DhanushMusunuru/FreshIQ/python/sample_data/tomato_spoiled.jpg

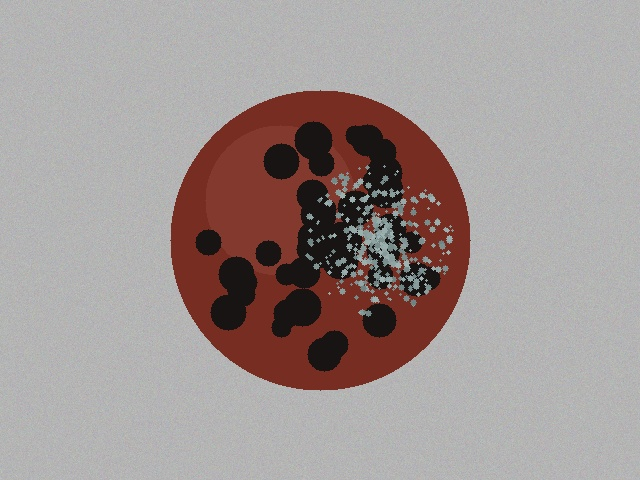
python/sample_data/tomato_spoiled.jpg
