DhanushMusunuru/FreshIQ/docs/schematics/freshiq-schematic.html

Sheet 1 of 1 · Rev A

# FreshIQ wiring

Tray drive and power for the FreshIQ inspection station. One 12 V supply, an A4988 driving a NEMA 17 from the UNO Q's 3.3 V header, a white LED strip and a USB camera.

Print / save as PDF

## Connections

A4988 | Goes to | Note
STEP | D2 | One pulse, one step.
DIR | D3 | Flip DIRECTION in the sketch if the tray turns the wrong way.
ENABLE | D5 | Active LOW. Held HIGH between moves so the motor is not left energised.
VDD | +3V3 | Logic supply. Not +5 V — see below.
GND (logic) | GND rail | Shared reference.
VMOT | +12 V | With C1 across it.
GND (motor) | GND rail | Star back to J1.
1A 1B | black, green | One coil — verify by continuity.
2A 2B | red, blue | The other coil.
MS1 MS2 MS3 | open | Full step. Internal pull-downs make open the default.
RESET + SLEEP | each other | JP1. A wire you add.

## Before first power-up

VDD must be 3.3 V

The A4988 reads logic HIGH at roughly 0.7 × VDD. On 5 V that threshold is 3.5 V and the UNO Q's outputs only reach 3.3 V, so STEP is never reliably seen. The motor then twitches, or works until it warms up — a fault that reads like a dead driver.

JP1 is not a factory jumper

RESET and SLEEP both float, and a floating RESET holds the chip in reset forever. Nothing moves and nothing is damaged, which is why people replace working drivers over it.

Fit C1 first

100 µF across VMOT and GND, within 50 mm of the driver. Motor inductance plus supply leads makes an LC circuit; powering up without bulk capacitance produces a spike well past 12 V that destroys the A4988. Same failure if you unplug the motor while powered.

## Current limit

Set it with a multimeter between the trimpot wiper and ground before the first move: Vref = I × 8 × Rsense. For 1.0 A with R100 (0.1 Ω) sense resistors that is 0.80 V; with R050 it is 0.40 V. The 17HS4401 is rated 1.68 A, but this tray is light and slow — 1.0 A runs cooler and costs nothing here.

FreshIQ · 4 compartments · 12 V 3 A · STEP D2, DIR D3, ENABLE D5. The drawing is also stored on its own as freshiq-wiring.svg.
