DhanushMusunuru/FreshIQ/python/sample_data/bad_blurred.jpg

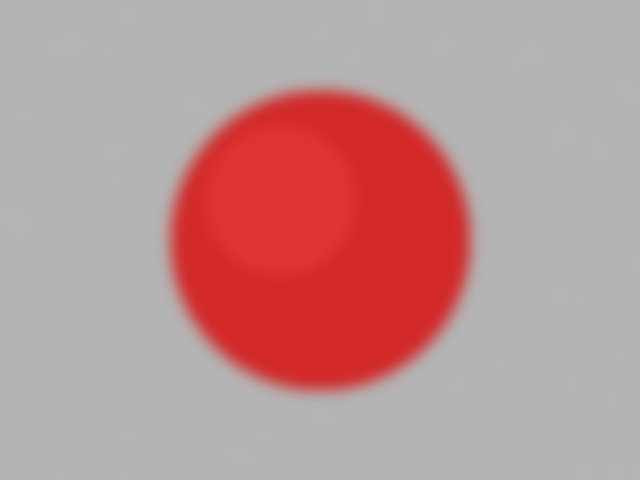
python/sample_data/bad_blurred.jpg
