DhanushMusunuru/FreshIQ/python/sample_data/bad_too_dark.jpg

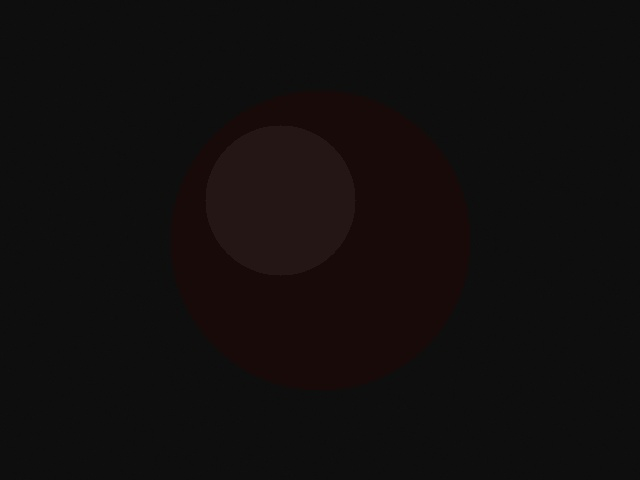
python/sample_data/bad_too_dark.jpg
