DhanushMusunuru/FreshIQ/python/sample_data/banana_fresh.jpg

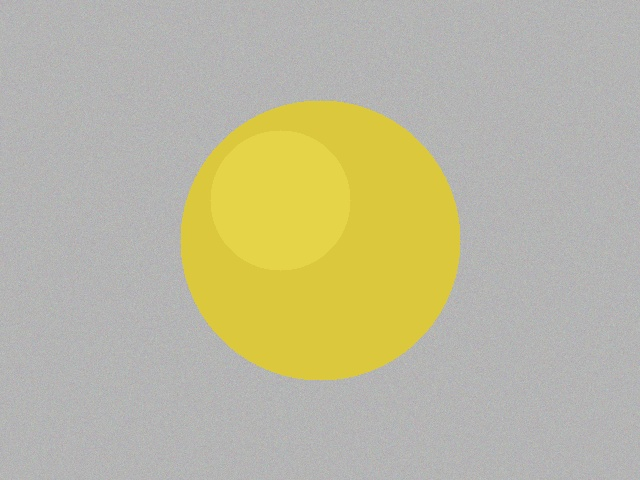
python/sample_data/banana_fresh.jpg
