DhanushMusunuru/FreshIQ/cad/export/step/FreshIQ_assembly.step

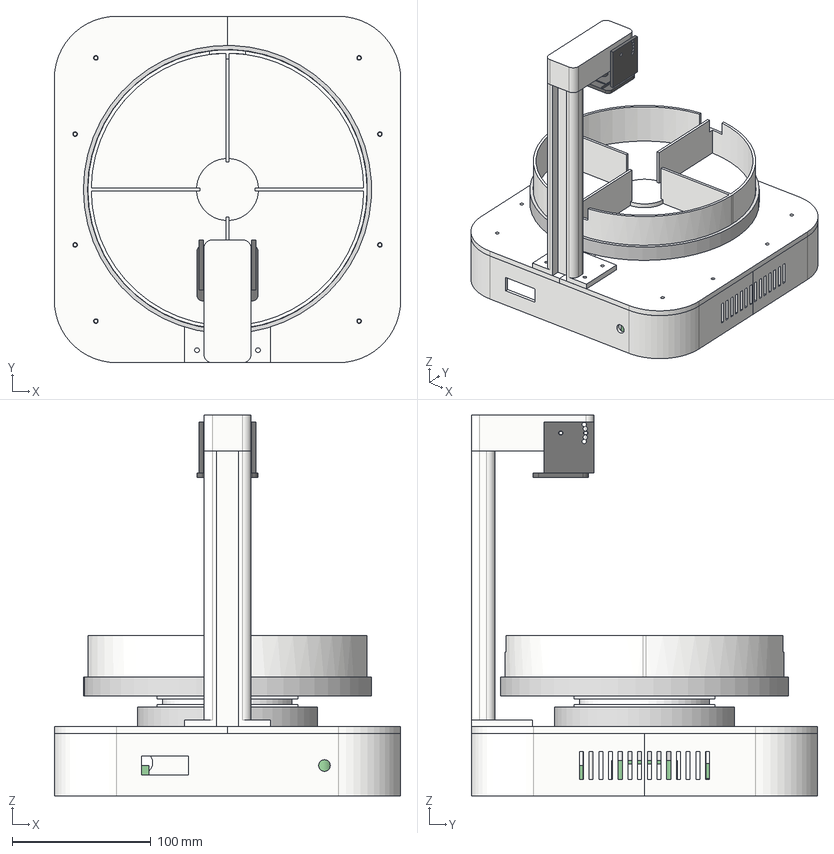
[picture p9: CAD file, 2026-08-23]
cad/export/step/FreshIQ_assembly.step
250.0 x 250.0 x 275.0 mm
