DhanushMusunuru/FreshIQ/cad/export/stl/05_Arm_Post.stl

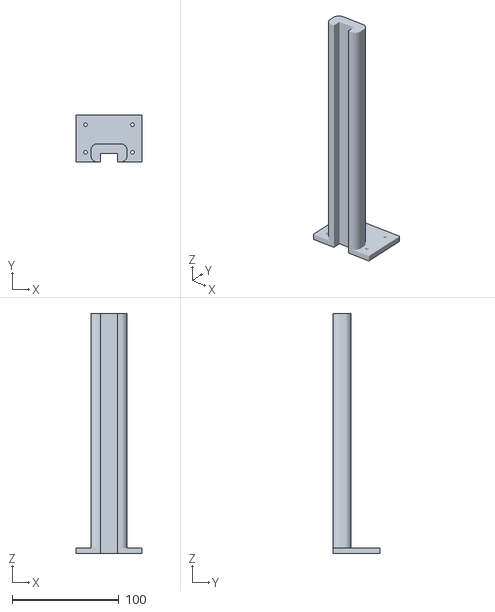
[picture p10: CAD file, 2026-08-23]
cad/export/stl/05_Arm_Post.stl
62.0 x 44.0 x 225.0
