DhanushMusunuru/FreshIQ/cad/export/stl/01_Base_Shell_A.stl

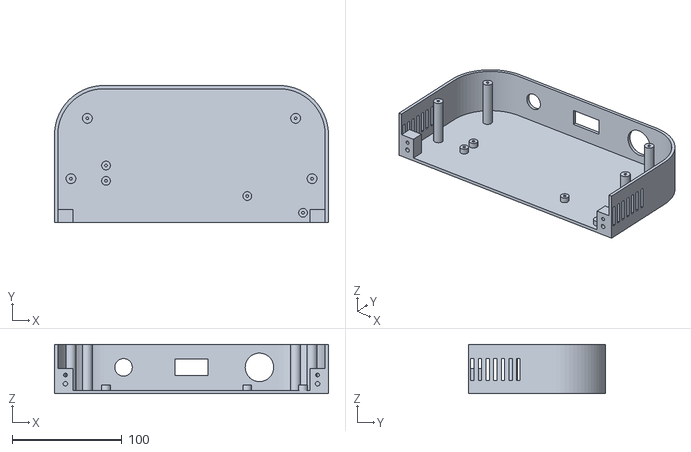
[picture p11: CAD file, 2026-08-23]
cad/export/stl/01_Base_Shell_A.stl
250.0 x 125.0 x 45.0
