DhanushMusunuru/FreshIQ/cad/export/stl/06_Arm_Head.stl

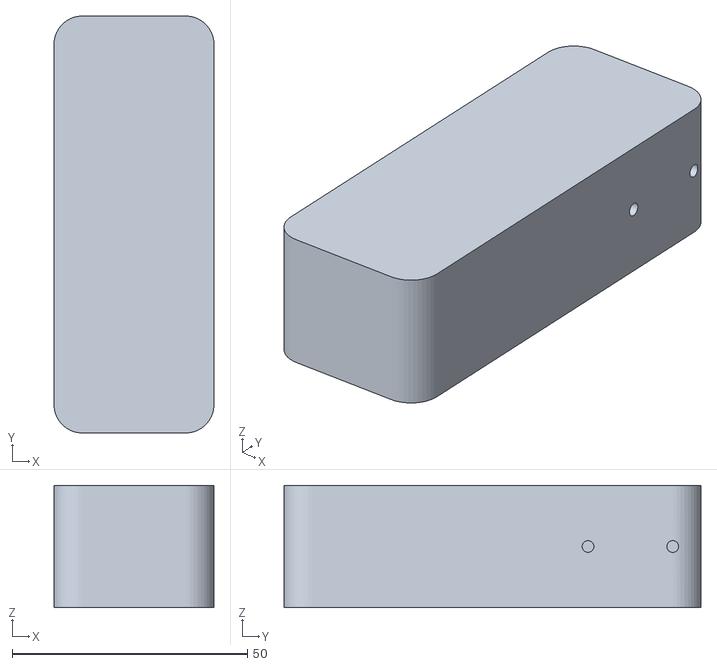
[picture p12: CAD file, 2026-08-23]
cad/export/stl/06_Arm_Head.stl
34.0 x 88.6 x 26.0
