DhanushMusunuru/FreshIQ/cad/export/stl/02_Deck_A.stl

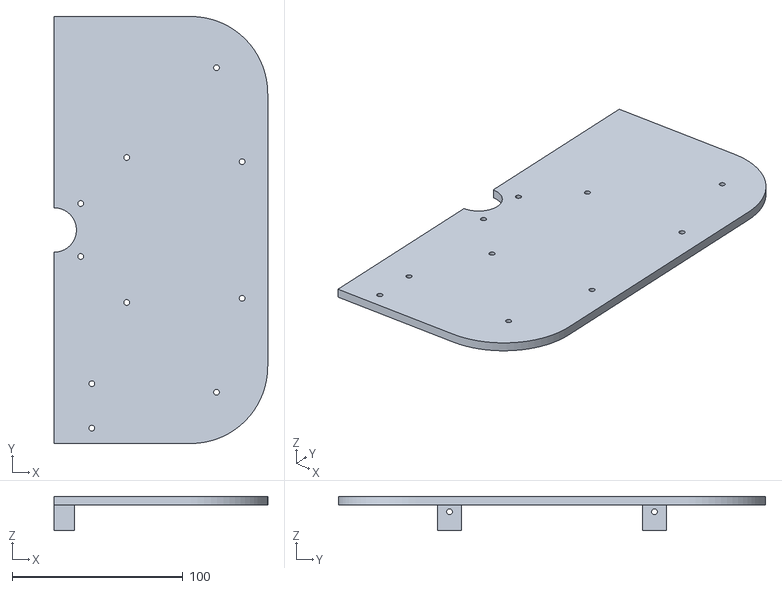
[picture p13: CAD file, 2026-08-23]
cad/export/stl/02_Deck_A.stl
125.0 x 250.0 x 20.0
