DhanushMusunuru/FreshIQ/cad/export/stl/08_Tray_Insert.stl

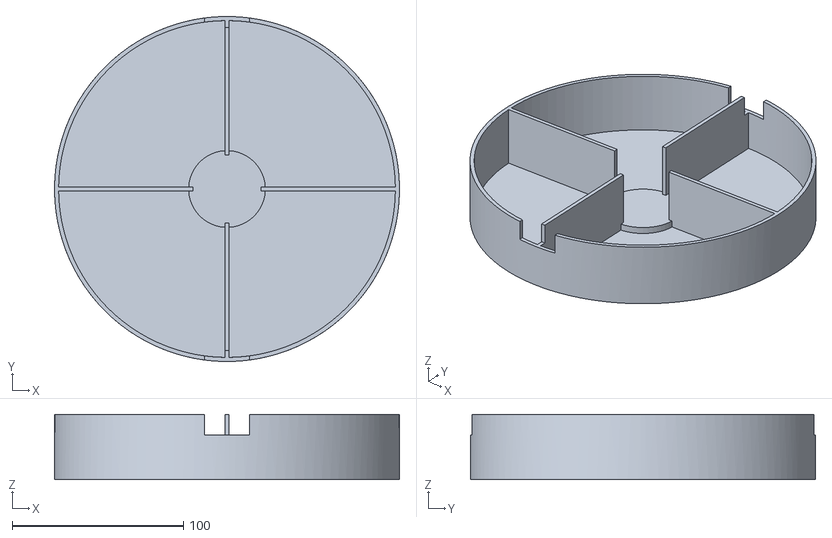
[picture p14: CAD file, 2026-08-23]
cad/export/stl/08_Tray_Insert.stl
201.5 x 201.5 x 38.0
