DhanushMusunuru/FreshIQ/cad/export/stl/03_Pedestal.stl

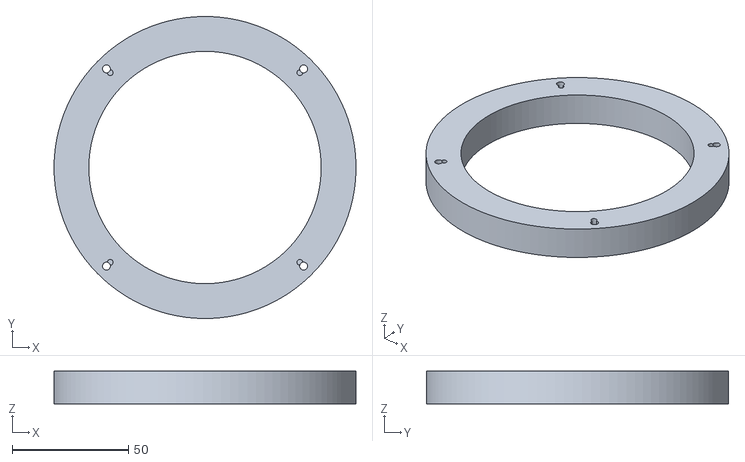
[picture p15: CAD file, 2026-08-23]
cad/export/stl/03_Pedestal.stl
130.0 x 130.0 x 14.1
