DhanushMusunuru/FreshIQ/cad/export/stl/07_Camera_Tilt_Bracket.stl

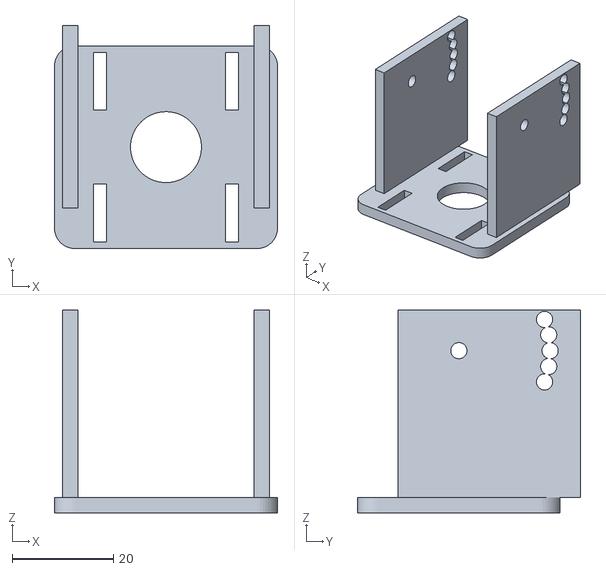
[picture p16: CAD file, 2026-08-23]
cad/export/stl/07_Camera_Tilt_Bracket.stl
44.0 x 44.0 x 40.0
