DhanushMusunuru/FreshIQ/cad/export/stl/04_Tray_Carrier.stl

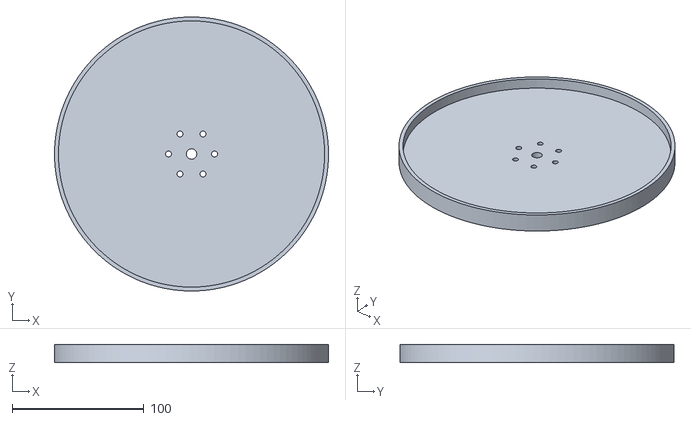
[picture p17: CAD file, 2026-08-23]
cad/export/stl/04_Tray_Carrier.stl
208.0 x 208.0 x 14.0
