DhanushMusunuru/FreshIQ/(list of files, cad)

Other CAD files:
cad/export/stl/02_Deck_B.stl
cad/export/stl/01_Base_Shell_B.stl
