DhanushMusunuru/FreshIQ/docs/freshiq-manual.html

Build & Wiring Manual

# FreshIQ

A four-compartment rotating tray that photographs each compartment in turn and classifies what it finds. One board does the vision and the web interface; a stepper indexes the tray. This is how it goes together and why it is built this way.

4 compartments 250 × 250 × 275 mm 12 V · 3 A 8 foods · 2 conditions 160 px model input 10 printed parts

## 01 How it works

Press Start scan. The tray turns one compartment, stops, waits for the platter to settle, takes a photo, classifies it, saves the result, and repeats until every compartment has an answer.

12 V power 3.3 V logic motor / data

One board, two processors. The UNO Q carries a Linux SoC and an STM32 microcontroller joined by an internal UART, so there is no external serial wiring — the driver connects straight to the 3.3 V header pins. That UART (/dev/ttyHS1) is owned exclusively by the arduino-router service, so Python reaches the MCU through the router's MessagePack-RPC socket, never by opening the port. Linux runs the model and the dashboard; the STM32 does the step timing, because Linux is not a real-time OS and a scheduler hiccup mid-step loses steps silently.

## 02 Parts list

Everything outside the printed enclosure.

Part | Spec | Notes
Arduino UNO Q | 4 GB | Linux + STM32 on one board. 68.6 × 53.3 mm. No barrel jack — power arrives on the VIN header pin.
NEMA 17 stepper | 17HS4401 class | 42.3 mm frame, 40 mm body, Ø5 mm shaft, 1.8°/step, 200 steps/rev.
A4988 carrier | 15.2 × 20.3 mm | Pololu-format. Check the sense resistors — see §5.
Coupling hub | Ø5 mm bore | Ø47 flange, 6 holes on 35 mm PCD, ~20 mm long. Measure yours — it sets the pedestal height.
Lazy-susan bearing | 4 in square | 101.6 mm plates, 7.94 mm thick, Ø57.15 mm access hole.
USB camera | 1/4 in CMOS | UVC-compliant. Appears as /dev/video0.
12 V supply | 3 A / 36 W | 5.5 × 2.1 mm centre-positive.
White LED strip | 12 V, ~0.5 m | Plain white. See §7 for why not RGB.
Capacitor | 100 µF, ≥25 V | Electrolytic. Not optional — see §4.

## 03 Power

One 12 V supply feeds three things directly. There is no buck converter, and you do not need one.

The UNO Q's VIN pin accepts 7–24 V and has its own on-board buck that feeds the 5 V system rail. 12 V is inside that range, so it goes straight in. An external step-down module would be a part that can fail for no benefit.

#### Motor

~1.0 A

A4988 VMOT, at the current limit you set in §5.

#### UNO Q

~1.0 A

Via VIN. Peaks during Wi-Fi bursts and model loading.

#### LED strip

~0.6 A

0.5 m of 12 V 5050 at ~14 W/m.

#### Headroom

3 A

Sized so nothing browns out when the motor starts.

Common ground

The A4988's logic ground and the UNO Q's ground must be joined. Without a shared reference, STEP and DIR are voltages measured against nothing — the driver sees noise, and the motor stutters or does nothing at all. Star the grounds at the supply.

## 04 Wiring the driver

This is the diagram to get right. Three of these connections are the classic ways an A4988 build fails silently.

12 V motor supply 3.3 V logic must be jumpered

Every connection on the A4988. Dashed stubs are pins deliberately left unconnected. The red link between RESET and SLEEP is a wire you add yourself — it is not a factory jumper.

### The three that bite

1 — VDD must be 3.3 V, not 5 V

The A4988 reads logic HIGH at roughly 0.7 × VDD. Powered from 5 V that threshold is 3.5 V, and the UNO Q's outputs only reach 3.3 V — so STEP is never reliably seen as HIGH. The symptom is maddening: the motor twitches, or turns sometimes, or works until it warms up. Powered from 3.3 V the threshold is 2.31 V and there is comfortable margin.

2 — RESET and SLEEP must be tied together

Both float by default, and a floating RESET holds the chip in reset forever. Nothing moves and nothing is broken, so people replace working drivers over this. One wire between the two pins fixes it.

3 — The 100 µF capacitor is not optional

It goes across VMOT and GND, physically close to the driver. The motor's inductance and the supply leads form an LC circuit; connecting power without bulk capacitance produces a voltage spike well beyond 12 V that destroys the A4988 outright. Fit it before the first power-up, not after.

Related: never unplug the motor while the driver is powered. Same failure, same result.

A4988 | Goes to | Why
STEP | D2 | One pulse, one step. Set in the sketch.
DIR | D3 | Rotation direction. Flip DIRECTION in the sketch if the tray turns the wrong way.
ENABLE | D5 | Active LOW. Driven HIGH between moves so the motor is not held energised and cooking.
VDD | +3V3 | Logic supply. See gotcha 1.
GND (logic) | GND | Shared reference.
VMOT | 12 V | With the 100 µF capacitor across it.
GND (motor) | 12 V GND | Star back to the supply.
1A 1B | black, green | One coil.
2A 2B | red, blue | The other coil.
MS1 MS2 MS3 | open | Full step. Internal pull-downs make open the default.
RESET + SLEEP | each other | See gotcha 2.

Confirm the coil pairs

Wire colours vary between suppliers. Set a multimeter to continuity and probe pairs: the two wires that beep are one coil. Getting this wrong makes the motor buzz and jitter instead of turning.

## 05 Motor current

Set this with a multimeter before the first move. Too high cooks the driver; too low loses steps under the tray's inertia — and nothing in software can detect a lost step.

Turn the trimpot and measure between the pot's wiper and ground:

V_ref = I_max × 8 × R_sense

Sense resistors | Marked | V_ref for 1.0 A
0.05 Ω | R050 | 0.40 V
0.10 Ω | R100 | 0.80 V
0.20 Ω | R200 | 1.60 V

The two small resistors sit beside the chip and carry the marking. 1.0 A is a good starting point — the 17HS4401 is rated 1.68 A, but this tray is light and turns slowly, and running cooler costs nothing here. If the tray stalls or skips, raise it in 0.1 A steps.

Heat

Above roughly 1 A the A4988 needs its heatsink and some airflow. The enclosure has side vents for this. If the driver is too hot to touch, lower the current before doing anything else.

## 06 Steps & indexing

The drive is 1:1 — the coupling hub goes straight on the motor shaft, no gearing — so one tray revolution is one motor revolution.

steps_per_compartment = steps_per_revolution × microsteps ÷ compartments
                      = 200 × 1 ÷ 4
                      = 50

Config validates this on startup and refuses to run if it does not divide evenly. At 3 compartments you would get 66.67 steps and the tray would creep out of alignment a little more every revolution — a fault that takes hours to notice and is invisible in a single scan.

There is no position sensor

No home switch, no encoder, no index mark. Absolute tray position is not physically knowable, so the software tracks a logical index that starts at compartment 1 when it boots. Turn the tray by hand so compartment 1 sits under the camera before your first scan.

If the motor ever skips steps, software cannot tell — the result would be labelled with the wrong compartment. That is a limitation of this hardware, not a bug. Correct it from the dashboard or with POST /api/motor/position.

Moves always go forward, never taking the short way round. Going 3 → 2 turns three compartments rather than reversing one, which keeps any mechanical backlash consistent so every compartment lands the same way.

## 07 Camera & light

The model judges food largely by colour. Everything here exists to make the light boring and identical from one compartment to the next.

### Why plain white, always on

The strip is wired straight to 12 V with no control line. That is deliberate: a strip that cannot be changed cannot drift. Use white only — an RGB strip set to "warm" shifts every hue the classifier depends on, and a red-tinted tomato and a red-tinted apple are a much harder problem than they need to be.

Aim for even, diffuse light with no hotspots. A strip around the inside of the enclosure rim, pointed at the tray rather than at the camera, avoids both glare and hard shadows.

### Camera geometry

#### Lens height

150 mm

Above the tray floor.

#### Field needed

52.2°

To cover one 90° compartment. Almost any module clears this.

#### Tilt

±20°

Five detents at −20/−10/0/+10/+20.

#### Aim point

r = 60.4

mm from centre — the compartment centroid.

The bracket uses discrete detent holes rather than a friction slot. A 3.4 mm slot through a 3 mm printed arm is a layer-delamination line waiting to split, it creeps under vibration once the clamp relaxes, and you cannot return to the same angle twice.

## 08 Mechanical stack

The vertical arrangement is the least obvious part of the build, because one component forces an addition you would not otherwise think to make.

the part that solves it coupling hub

The pedestal exists because of the hub. The coupling hub is ~20 mm long and has to both grip the shaft and bolt up to the tray, but the bearing is only 7.94 mm thick. Mounting both flat to the deck makes the hub collide with the motor face. A 14.06 mm ring lifts the bearing so its top plate lands exactly at the hub flange — and the hub then lives inside the bearing's Ø57.15 mm access hole, which the Ø47 flange clears.

## 09 Software map

One Python process serves the API, the dashboard and the scan controller. No separate frontend server, no broker, no database daemon.

Path | Does
config/freshiq.json | Everything about this rig: compartments, port, camera, delays, retention.
hardware/motor.py | Tray movement. Router-RPC, external-serial and simulated drivers behind one interface.
hardware/router_bridge.py | MessagePack-RPC to the UNO Q's on-board MCU via arduino-router.
hardware/lighting.py | Reports the hardwired strip honestly; refuses to pretend it can dim.
backend/scan.py | The state machine. Owns the compartment index.
backend/server.py | HTTP: API + dashboard. Standard library only.
backend/dashboard.html | The UI, including the compartment grid.
ai/quality_check.py | Rejects unusable frames before the model ever sees them.
ai/multihead.py | Runs the two-head TFLite model.
ai/aggregation.py | Combines several views of one item — worst view wins.
camera/capture.py | USB capture.
firmware/freshiq_tray/ | The MCU sketch.

Why the scan controller exists

ai.inspect() merges N images into one verdict. That is right for four photos of one tomato and wrong for four compartments holding four different foods — it would average a fresh apple and a rotten banana into a single answer. The scan controller inverts the loop: it calls inspect() once per compartment. The AI package itself is unmodified.

## 10 The scan cycle

the only moment the shutter opens failure & cancel

The tray is never moving while a photo is taken. move_to() blocks until the microcontroller replies OK, and only then does the settle delay run — the motor stopping is not the same as a 200 mm loaded platter having stopped wobbling. Every exit, including cancellation, passes through SAFE_STOP, so no exception can leave a stepper energised.

## 11 The model

MobileNetV2 with two output heads, exported to TFLite and run through LiteRT. Verified against the actual tensors, not the docs.

Bad frames never reach the model. The gate rejects them with a named reason, so you get "blurred" instead of a confident guess about a photo of nothing.

#### Input

160 × 160

RGB float32 in [0,1]. Verified from the input tensor.

#### Outputs

2 and 8

Condition and food. Neither head is quantised.

#### Size

2.72 MB

freshiq_model.tflite.

#### Runtime

LiteRT

ai-edge-litert. No TensorFlow on the board.

### What it actually knows

Eight foods: apple, banana, cucumber, mango, okra, orange, potato, tomato. Two conditions: fresh, spoiled.

Anything else gets forced into one of those eight — the model cannot say "I have not seen this". Feed it a pear and you will get a confident wrong answer.

Preprocessing must not be changed

BGR → RGB, resize to 160, divide by 255. The model applies its own rescaling internally. A mismatch between training and deployment preprocessing does not throw an error — it quietly destroys accuracy while everything still looks like it is working.

## 12 HTTP API

Bound to 0.0.0.0:8000 so phones and laptops on the same Wi-Fi can reach it.

Method | Path | Purpose
POST | /api/scan/start | Scan every compartment. Optional {"compartments":[2,4]}.
POST | /api/scan/stop | Cancel. Motor stops immediately.
POST | /api/scan/compartment | One compartment, synchronous.
GET | /api/scan/status | State, progress, results so far.
GET | /api/system/status | One call: AI, camera, tray, lighting, mode.
GET | /api/motor/status | Position, moving, connected.
POST | /api/motor/position | Correct the index after realigning by hand.
GET | /api/snapshot | Current frame as JPEG.
GET | /api/history | Past inspections, newest first.
GET | /api/export.csv | Everything as CSV.

### One result

{
  "status": "ok",
  "compartment": 2,
  "food": "tomato",
  "food_confidence": 0.97,
  "condition": "fresh",
  "condition_confidence": 0.96,
  "image_quality": "good",
  "evidence": [],
  "timestamp": "2026-08-23T05:43:52+00:00"
}

compartment comes from the scan controller, never from the model. Results are appended to data/inspections.jsonl — one JSON object per line, which survives a power cut mid-write (you lose at most the last line) and needs no schema migration.

## 13 Installing

Copy the folder to the board and run one thing.

./START.sh

First run installs the system libraries and Python packages, verifies the imports actually work, adds you to the dialout group, creates the data folders, then starts and prints the address. Every run after that just starts.

./INSTALL_SERVICE.sh

Starts on boot, restarts on crash. Watch it with journalctl -u freshiq -f.

### Without any hardware

./START.sh --dev

Simulated motor, sample photos instead of a camera, everything else real. The whole scan flow and dashboard work on a laptop with nothing plugged in.

Network exposure

There is no authentication. Anyone on your Wi-Fi can open the dashboard and drive the tray. Fine for a LAN prototype; do not port-forward it. For remote access use a private tunnel such as Tailscale, which exposes nothing publicly.

## 14 When it breaks

Symptom | Cause | Fix
Motor hums, will not turn | Coil pairs swapped | Meter for continuity; the pair that beeps is one coil
Nothing moves, nothing hot | RESET floating | Jumper RESET to SLEEP
Turns sometimes / erratic | VDD on 5 V | Move VDD to +3V3
Skips steps under load | Current too low | Raise V_ref 0.1 A at a time
Driver very hot | Current too high | Lower V_ref; check the heatsink
Driver died on power-up | No bulk capacitor | Fit 100 µF across VMOT. The driver is gone.
Everything blurred | Threshold tuned for a rig camera | ./START.sh --min-focus 20
Backend says heuristic | Model missing | models/ is gitignored — copy the .tflite
camera.mode: demo | No /dev/video* | Replug; sudo fuser -v /dev/video0
scan_unavailable on an UNO Q | Router driver not selected | Set "driver": "auto"; check systemctl status arduino-router
Serial permission denied (external board only) | Not in dialout | sudo usermod -aG dialout $USER, then log out
Wrong compartment reported | Lost steps or misalignment | Realign by hand; raise current; slow the ramp
libGL.so.1 missing | OpenCV system deps | sudo apt install -y libgl1 libglib2.0-0

## 15 Honest limits

Read this before showing anyone a number.

This is not a food-safety device

The percentages are the model's classification confidence, not a measurement. "Fresh classification: 96% confidence" does not mean the food is 96% fresh, and it says nothing about whether anything is safe to eat. There is no chemistry here — only the appearance of the surface facing a camera.

no | Position feedback. No home switch or encoder. Lost steps are undetectable.
no | Object detection. One item per compartment. Two foods together gets you multiple_objects, not two answers.
no | Unknown-food rejection. Anything outside the eight classes is forced into one of them.
no | Interior assessment. Surface appearance only. A perfect-looking fruit can be rotten inside.
note | Domain gap. Trained on web photos of supermarket produce, not photos from this rig. It will do worse here than its test score suggests.
note | FDM prints are not food-safe. Layer lines trap bacteria and survive washing. The tray is for whole uncut fruit; hand-wash cool, never a dishwasher.
yes | Bad frames are refused rather than guessed at, with a named reason.
yes | The tray fails safe. Every error path de-energises the motor.

The dashboard's Teach it your setup panel collects photos from your actual camera and lighting. That is the single highest-value thing you can do to close the domain gap.

FreshIQ build manual · 4 compartments · 70.2 cm² each · 12 V · 8 foods, 2 conditions. Dimensions measured from the built CAD geometry; model specifications read from the deployed .tflite tensors.
