DhanushMusunuru/FreshIQ/(commit log)

2026-08-23 FreshIQ: merge board build with CAD, tests and docs; fix three defects
    Merges the working UNO Q build (freshIQfinal2) with the local tree's CAD,
    test suite and documentation, keeping the App Lab layout the board runs.
    Base is the board version deliberately: its tray, camera and AI are proven
    working on hardware, so its hardware/ and camera/ win over the local copies.
    Fixes found while reviewing the merge:
    * python/backend/service.py imported cgi, removed from the stdlib in Python
    3.13 - which is what the UNO Q runs. The path could only ever raise
    ModuleNotFoundError on the target, so it now fails with a message pointing
    at backend/server.py. build_inspection_record() is untouched.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
    [animate.py, bridge_rpc.py, build.py]
2026-08-23 Complete the merge: reconcile both trees file-by-file
    The first pass took the board build wholesale. This one compares the two trees
    file-by-file and resolves each difference on merit rather than by origin.
    Kept from the board build (verified newer): camera/capture.py with its
    multi-source fallback, hardware/ with bridge_rpc + BridgeTrayMotor,
    DEPLOYMENT.md and requirements.txt, which describe the arduino-router
    architecture the local copies still predated.
    Confirmed already present, nothing lost: ScanCancelled, the cancel-flag clear,
    the camera frame-retry, the scan endpoints, the dashboard compartment grid, and
    the ai/config.py '8 trained foods, not 13' correction.
    Brought across from t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
    [01_Base_Shell_A.stl, 01_Base_Shell_B.stl, 02_Deck_A.stl, 02_Deck_B.stl, 03_Pedestal.stl, 04_Tray_Carrier.stl, 05_Arm_Post.stl, 06_Arm_Head.stl]
2026-08-23 Consolidate to a single project folder
    The repository and the older working tree existed side by side. Everything of
    value from the old tree is now here - the trainable freshiq_model.keras, the
    rendered explainer clips, the print pack and the dataset skeleton - and the
    duplicate is gone. Only router_bridge.py and its test were dropped, both
    superseded by the board's bridge_rpc.py.
    The dataset skeleton lets tests/test_training_layout.py run rather than skip,
    so the suite is 117 passed, 1 skipped.
    Large binaries stay on disk but out of the repo: the .keras trainable model,
    the video renders, and the float tflite export - the last because config points
    at freshiq_model.tflite and shipping bot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
2026-08-23 Add make_app_bundle.sh: build exactly what App Lab imports
    The repository holds CAD, tests, training and docs that must never reach the
    board. This produces build/FreshIQ/ containing only app.yaml, python/ and
    sketch/ - 45 files, 2.8 MB - and asserts the model, labels, app.yaml and sketch
    are present rather than shipping a bundle that is quietly missing one.
    Excludes freshiq_model.keras and the float export deliberately: the device
    loads freshiq_model.tflite, and shipping alternatives invites deploying the
    wrong one, which loses accuracy silently instead of failing.
2026-08-23 Start both halves from START.sh, and say which camera fault it is
    Two dashboard banners, one shared cause and one bad message.
    "Tray control unavailable - the MCU did not answer tray_status": START.sh
    only ever launched the Linux half. The sketch that answers tray_status is
    flashed by `arduino-app-cli app start`, which nothing was calling, so the
    MPU was talking to an MCU running whatever it had been flashed with last.
    START.sh now detects App Lab and delegates to it, which flashes the sketch
    and runs python/main.py as one unit. --python-only keeps the old behaviour
    for a laptop with no board attached.
    The delegation also runs `app stop` first, which releases /dev/video0 from
    a previous in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
2026-08-23 Report where dashboard.html was looked for, and check it at boot
    "dashboard.html is missing" was a 500 body with nothing else in it: no
    path, no hint about which copy of the tree was being served. On a board
    where the app is installed under ~/ArduinoApps/FreshIQ, that is the one
    piece of information you actually need.
    The lookup now walks a short candidate list and, on failure, reports every
    path it tried plus a listing of the directory it expected the file in. The
    file ships in python/backend/ and is in the bundle, so an absence means the
    copy on the device is incomplete - the message says that rather than making
    you infer it.
    It is also checked at startup instead of at the first request.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
    [server.py]
2026-10-14 Backup before Windows installation
    [training_log.csv, training_log_finetune.csv]
